robertopapi/ESP8266/(commit log)

2026-10-11 Add electrical schematic image to README
    Added an electrical schematic image to the README file.
2026-10-11 Revise README with connector and software details
    Updated the README to clarify the connector description and added details about software issues related to flash memory access and the implementation of an editable vocabulary for speech commands.
2026-10-16 Clarify bit rotation explanation in README
    Corrected the explanation regarding the bit rotation of binary sequences due to differences in technology between Arduino and ESP-12F.
2026-10-16 Update README with clarification on binary sequence rotation
    Clarified the explanation regarding the rotation of binary sequences due to differences in technology between Arduino and ESP-12F.
2026-10-16 Update README to clarify binary sequence rotation
    Clarified the explanation of binary sequence rotation for IR codes, specifying the use of the LSB2MSB() function and the differences between Arduino and ESP-12F circuits.
2026-10-16 Include assembly and exploded view images in README
    Added images of the assembled circuit and exploded view in the README.
2026-10-16 Fix image link for assembled circuit
    Updated image link for the assembled circuit in README.
2026-10-16 Enhance README with detailed circuit explanation
    Clarified the explanation of the microcontroller circuit, emphasizing the dedicated USB connector and its benefits for power decoupling. Added details about the RC circuit on the RST pin and the inclusion of jumpers for GPIO flexibility.
